Drawm07/smart-home-stm32/Core/Inc/main.h

#define B1_Pin GPIO_PIN_13
#define B1_GPIO_Port GPIOC
#define B1_EXTI_IRQn EXTI15_10_IRQn
#define USART_TX_Pin GPIO_PIN_2
#define USART_TX_GPIO_Port GPIOA
#define USART_RX_Pin GPIO_PIN_3
#define USART_RX_GPIO_Port GPIOA
#define LED_ALARME_Pin GPIO_PIN_8
#define LED_ALARME_GPIO_Port GPIOA
#define BOUTON_FEN_Pin GPIO_PIN_10
#define BOUTON_FEN_GPIO_Port GPIOA
#define BOUTON_FEN_EXTI_IRQn EXTI15_10_IRQn
#define TMS_Pin GPIO_PIN_13
#define TMS_GPIO_Port GPIOA
#define TCK_Pin GPIO_PIN_14
#define TCK_GPIO_Port GPIOA
#define SWO_Pin GPIO_PIN_3
#define SWO_GPIO_Port GPIOB
#define PIR_Pin GPIO_PIN_5
#define PIR_GPIO_Port GPIOB
#define PIR_EXTI_IRQn EXTI9_5_IRQn
